UCI-Rocket-Project/rocket2-trs-hardware/README.md

## 🛰️ Telemetry Radio System (TRS) 🛰️
Click [here](https://uci-rocket-project.github.io/rocket2-trs-hardware/) TRS documentation
