UCI-Rocket-Project/rocket2-trs-hardware/docs/assets/av-system-diagram.png

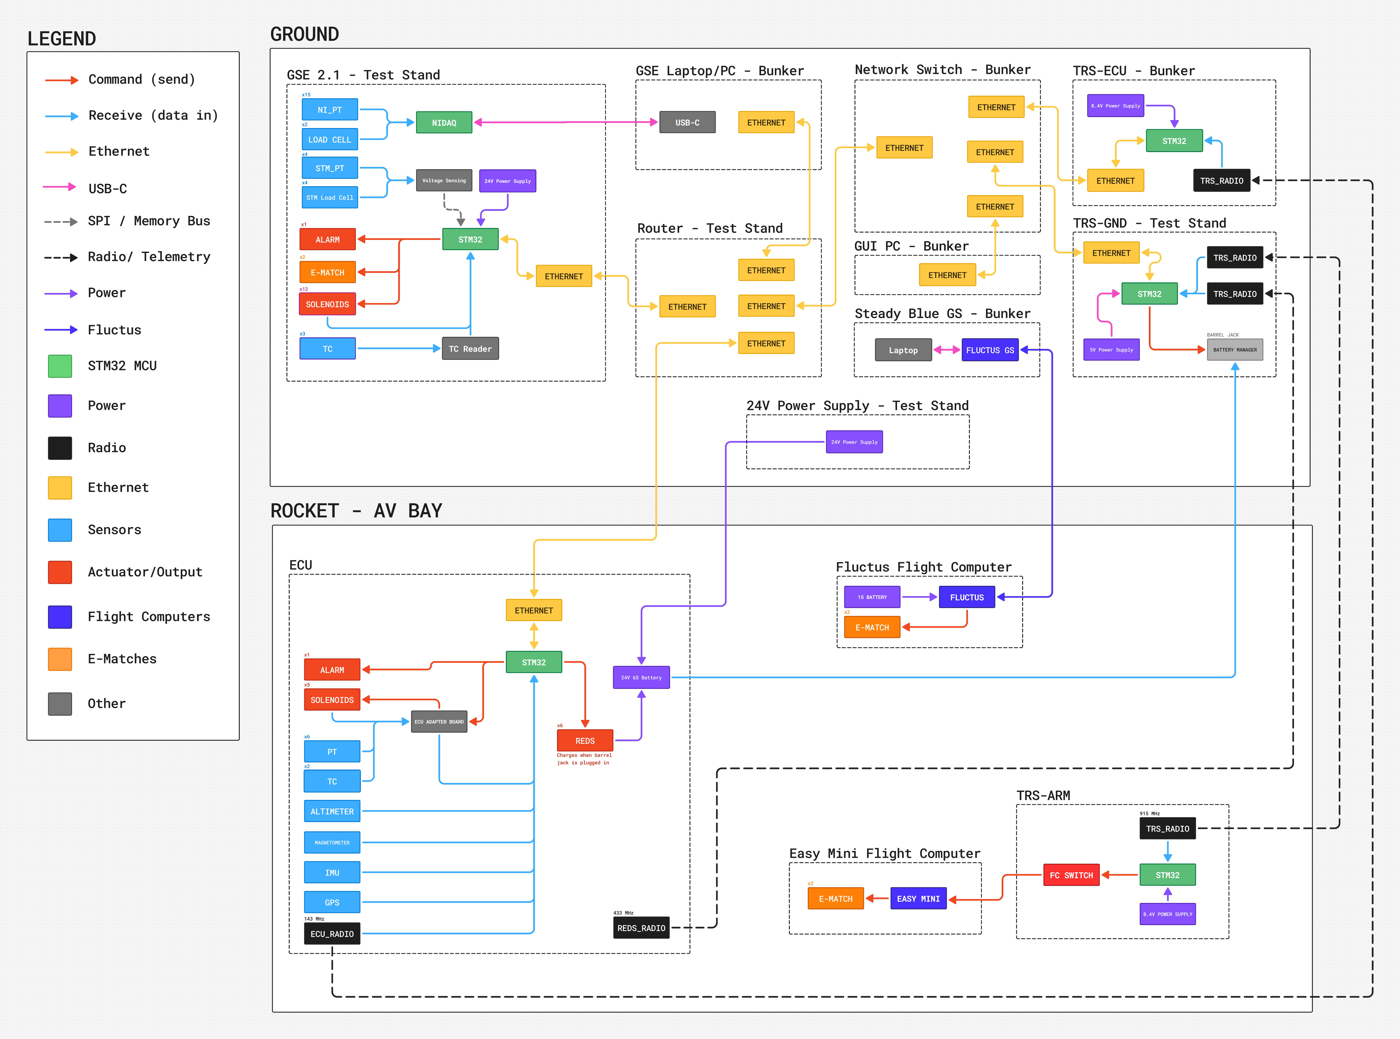
docs/assets/av-system-diagram.png
