UCI-Rocket-Project/rocket2-trs-hardware/TRS-KICAD/rocket2-trs-hardware.kicad_pcb

## KiCad design TRS-KICAD/rocket2-trs-hardware.kicad_pcb (2026-02-01)

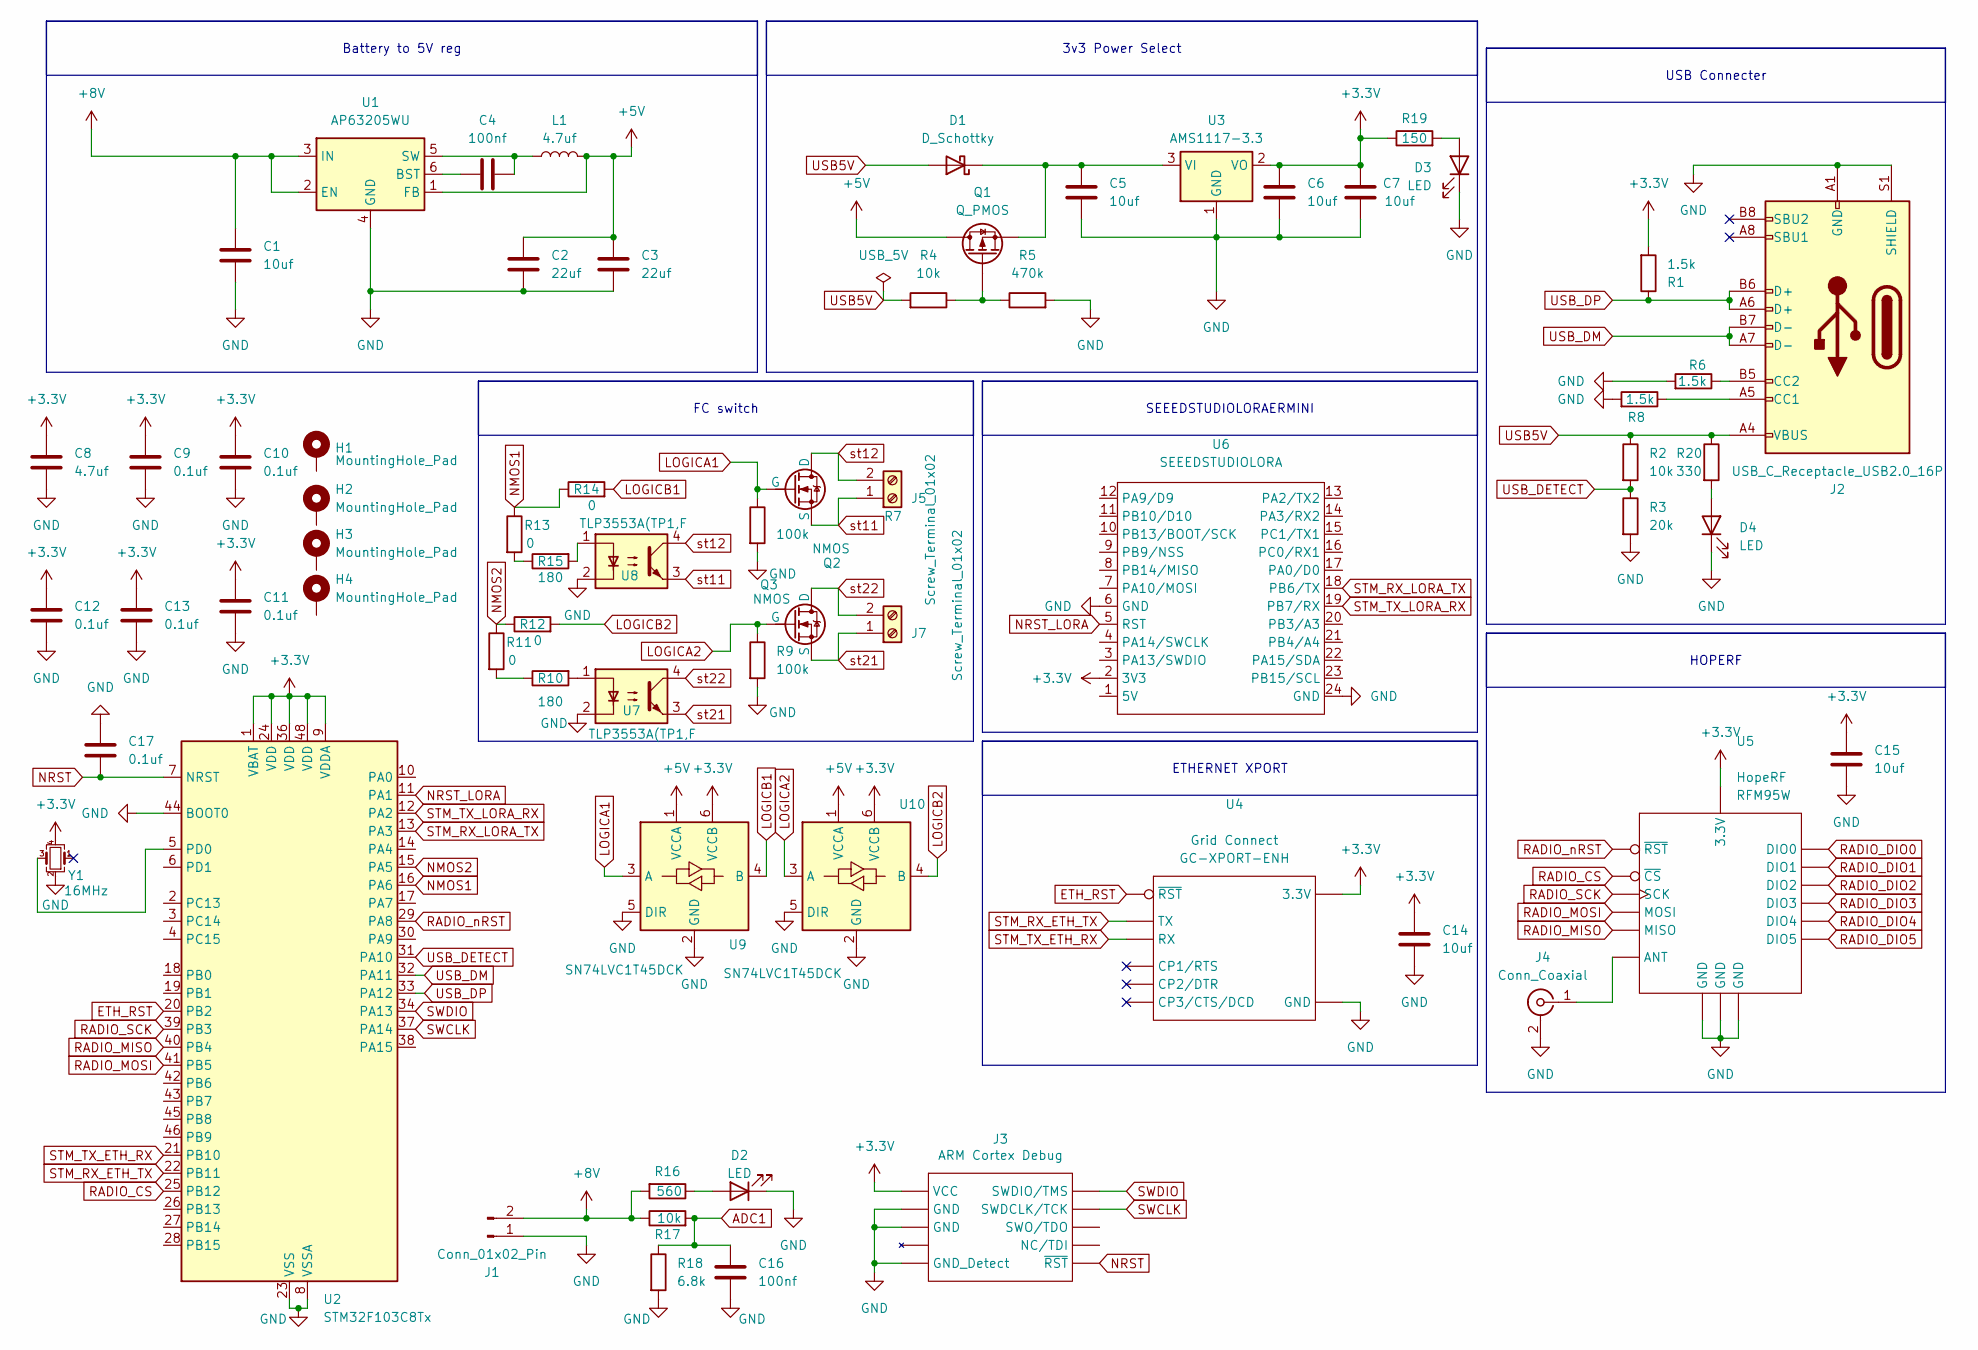
[picture p13: schematic rocket2-trs-hardware.kicad_sch]

Parts:
C1, C5, C6, C7, C14, C15: 10uf; C_0603_1608Metric_Pad1.08x0.95mm_HandSolder
C2, C3: 22uf; C_0603_1608Metric_Pad1.08x0.95mm_HandSolder
C4, C16: 100nf; C_0603_1608Metric_Pad1.08x0.95mm_HandSolder
C8: 4.7uf; C_0603_1608Metric_Pad1.08x0.95mm_HandSolder
C9, C10, C11, C12, C13, C17: 0.1uf; C_0603_1608Metric_Pad1.08x0.95mm_HandSolder
D1: D_Schottky; D_SMA_Handsoldering
D2, D3, D4: LED; R_0603_1608Metric_Pad0.98x0.95mm_HandSolder
H1, H2, H3, H4: MountingHole_Pad; MountingHole_4.3mm_M4_DIN965_Pad_TopBottom
J1: Conn_01x02_Pin; AMASS_XT60PW-M_1x02_P7.20mm_Horizontal
J2: USB_C_Receptacle_USB2.0_16P; USB_C_Receptacle_GCT_USB4105-xx-A_16P_TopMnt_Horizontal
J3: ARM Cortex Debug; PinHeader_2x05_P1.27mm_Vertical_SMD
J4: Conn_Coaxial; CONN_73391-0070_MOL
J5, J7: Screw_Terminal_01x02; TerminalBlock_Phoenix_MKDS-1,5-2-5.08_1x02_P5.08mm_Horizont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
L1: 4.7uf; C_0603_1608Metric_Pad1.08x0.95mm_HandSolder
Q1: Q_PMOS; TSOT-23_HandSoldering
Q2, Q3: NMOS; SOT-23-6
R1, R6, R8: 1.5k; R_0603_1608Metric_Pad0.98x0.95mm_HandSolder
R2, R4, R17: 10k; R_0603_1608Metric_Pad0.98x0.95mm_HandSolder
R3: 20k; R_0603_1608Metric_Pad0.98x0.95mm_HandSolder
R5: 470k; R_0603_1608Metric_Pad0.98x0.95mm_HandSolder
R7, R9: 100k; R_0603_1608Metric_Pad0.98x0.95mm_HandSolder
R10, R15: 180; R_0603_1608Metric_Pad0.98x0.95mm_HandSolder
R11, R12, R13, R14: 0; R_0603_1608Metric_Pad0.98x0.95mm_HandSolder
R16: 560; R_0603_1608Metric_Pad0.98x0.95mm_HandSolder
R18: 6.8k; R_0603_1608Metric_Pad0.98x0.95mm_HandSolder
R19: 150; R_0603_1608Metric_Pad0.98x0.95mm_HandSolder
R20: 330; R_0603_1608Metric_Pad0.98x0.95mm_HandSolder
U1: AP63205WU; TSOT-23-6
U2: STM32F103C8Tx; LQFP-48_7x7mm_P0.5mm
U3: AMS1117-3.3; SOT-223-3_TabPin2
U4: GC-XPORT; Part # GC-XPORT-ENH
U5: RFM95W; Part # RFM95W
U6: SEEEDSTUDIOLORA; Untitled
U7: TLP3553A(TP1,F; optocoupler
U8: TLP3553A(TP1,F; optocoupler; Part# TLP3553A(TP1,F
U9, U10: SN74LVC1T45DCK; SOT-363_SC-70-6
Y1: 16MHz; Crystal_SMD_2016-4Pin_2.0x1.6mm; Part # ECS-1633-160-BN-TR

Connections:
+3.3V: C6.1, C7.1, C8.1, C9.1, C10.1, C11.1, C12.1, C13.1, C14.1, C15.1, J3.1 (VCC), R1.2, R19.1, U2.1 (VBAT), U2.9 (VDDA), U2.24 (VDD), U2.36 (VDD), U2.48 (VDD), U3.2 (VO), U4.2 (3.3V), U5.13 (3.3V), U6.2 (3V3), U9.6 (VCCB), U10.6 (VCCB), Y1.4
+5V: C2.1, C3.1, L1.2, Q1.3 (D), U1.1 (FB), U9.1 (VCCA), U10.1 (VCCA)
+8V: C1.1, J1.2, R16.2, R17.1, U1.2 (EN), U1.3 (IN)
ADC1: C16.1, R17.2, R18.1
ETH_RST: U2.20 (PB2), U4.3 (~RST)
GND: C1.2, C2.2, C3.2, C5.2, C6.2, C7.2, C8.2, C9.2, C10.2, C11.2, C12.2, C13.2, C14.2, C15.2, C16.2, C17.2, D2.1 (K), D3.1 (K), D4.1 (K), J1.1, J2.A1 (GND), J2.A12 (GND), J2.B1 (GND), J2.B12 (GND), J2.S1 (SHIELD), J3.3 (GND), J3.5 (GND), J3.9 (GND_Detect), J4.2 (Ext), R3.2, R5.2, R6.2, R7.2, R8.2, R9.2, R18.2, U1.4 (GND), U2.8 (VSSA), U2.23 (VSS), U2.35 (VSS), U2.44 (BOOT0), U2.47 (VSS), U3.1 (GND), U4.1 (GND), U5.1 (GND), U5.8 (GND), U5.10 (GND), U6.6 (GND), U6.24 (GND), U7.2, U8.2, U9.2 (GND), U9.5 (DIR), U10.2 (GND), U10.5 (DIR), Y1.2
LOGICA1: Q2.3 (G), R7.1, U9.3 (A)
LOGICA2: Q3.3 (G), R9.1, U10.3 (A)
LOGICB1: R14.2, U9.4 (B)
LOGICB2: R12.2, U10.4 (B)
NMOS1: R13.1, R14.1, U2.16 (PA6)
NMOS2: R11.1, R12.1, U2.15 (PA5)
NRST: C17.1, J3.10 (~RST), U2.7 (NRST)
NRST_LORA: U2.11 (PA1), U6.5 (RST)
unnamed: C5.1, D1.1 (K), Q1.2 (S), U3.3 (VI)
unnamed: D2.2 (A), R16.1
unnamed: D3.2 (A), R19.2
unnamed: D4.2 (A), R20.2
unnamed: J2.A5 (CC1), R8.1
unnamed: J2.B5 (CC2), R6.1
unnamed: J4.1 (In), U5.9 (ANT)
unnamed: Q1.1 (G), R4.1, R5.1
unnamed: R10.1, R11.2
unnamed: R10.2, U7.1
unnamed: R13.2, R15.1
unnamed: R15.2, U8.1
unnamed: C4.2, U1.6 (BST)
unnamed: C4.1, L1.1, U1.5 (SW)
unnamed: U2.5 (PD0), Y1.3
RADIO_CS: U2.25 (PB12), U5.5 (~CS)
RADIO_DIO0: U5.14 (DIO0)
RADIO_DIO1: U5.15 (DIO1)
RADIO_DIO2: U5.16 (DIO2)
RADIO_DIO3: U5.11 (DIO3)
RADIO_DIO4: U5.12 (DIO4)
RADIO_DIO5: U5.7 (DIO5)
RADIO_MISO: U2.40 (PB4), U5.2 (MISO)
RADIO_MOSI: U2.41 (PB5), U5.3 (MOSI)
RADIO_SCK: U2.39 (PB3), U5.4 (SCK)
RADIO_nRST: U2.29 (PA8), U5.6 (~RST)
STM_RX_ETH_TX: U2.22 (PB11), U4.4 (TX)
STM_RX_LORA_TX: U2.13 (PA3), U6.18 (PB6/TX)
STM_TX_ETH_RX: U2.21 (PB10), U4.5 (RX)
STM_TX_LORA_RX: U2.12 (PA2), U6.19 (PB7/RX)
SWCLK: J3.4 (SWDCLK/TCK), U2.37 (PA14)
SWDIO: J3.2 (SWDIO/TMS), U2.34 (PA13)
USB5V: D1.2 (A), J2.A4 (VBUS), J2.A9 (VBUS), J2.B4 (VBUS), J2.B9 (VBUS), R2.1, R4.2, R20.1
USB_DETECT: R2.2, R3.1, U2.31 (PA10)
USB_DM: J2.A7 (D-), J2.B7 (D-), U2.32 (PA11)
USB_DP: J2.A6 (D+), J2.B6 (D+), R1.1, U2.33 (PA12)
st11: J5.1, Q2.4 (S), U8.3
st12: J5.2, Q2.1 (D), U8.4
st21: J7.1, Q3.4 (S), U7.3
st22: J7.2, Q3.1 (D), U7.4

Notes on the sheet:
FC switch
3v3 Power Select
HOPERF
USB Connecter
ETHERNET XPORT
SEEEDSTUDIOLORAERMINI
Battery to 5V reg

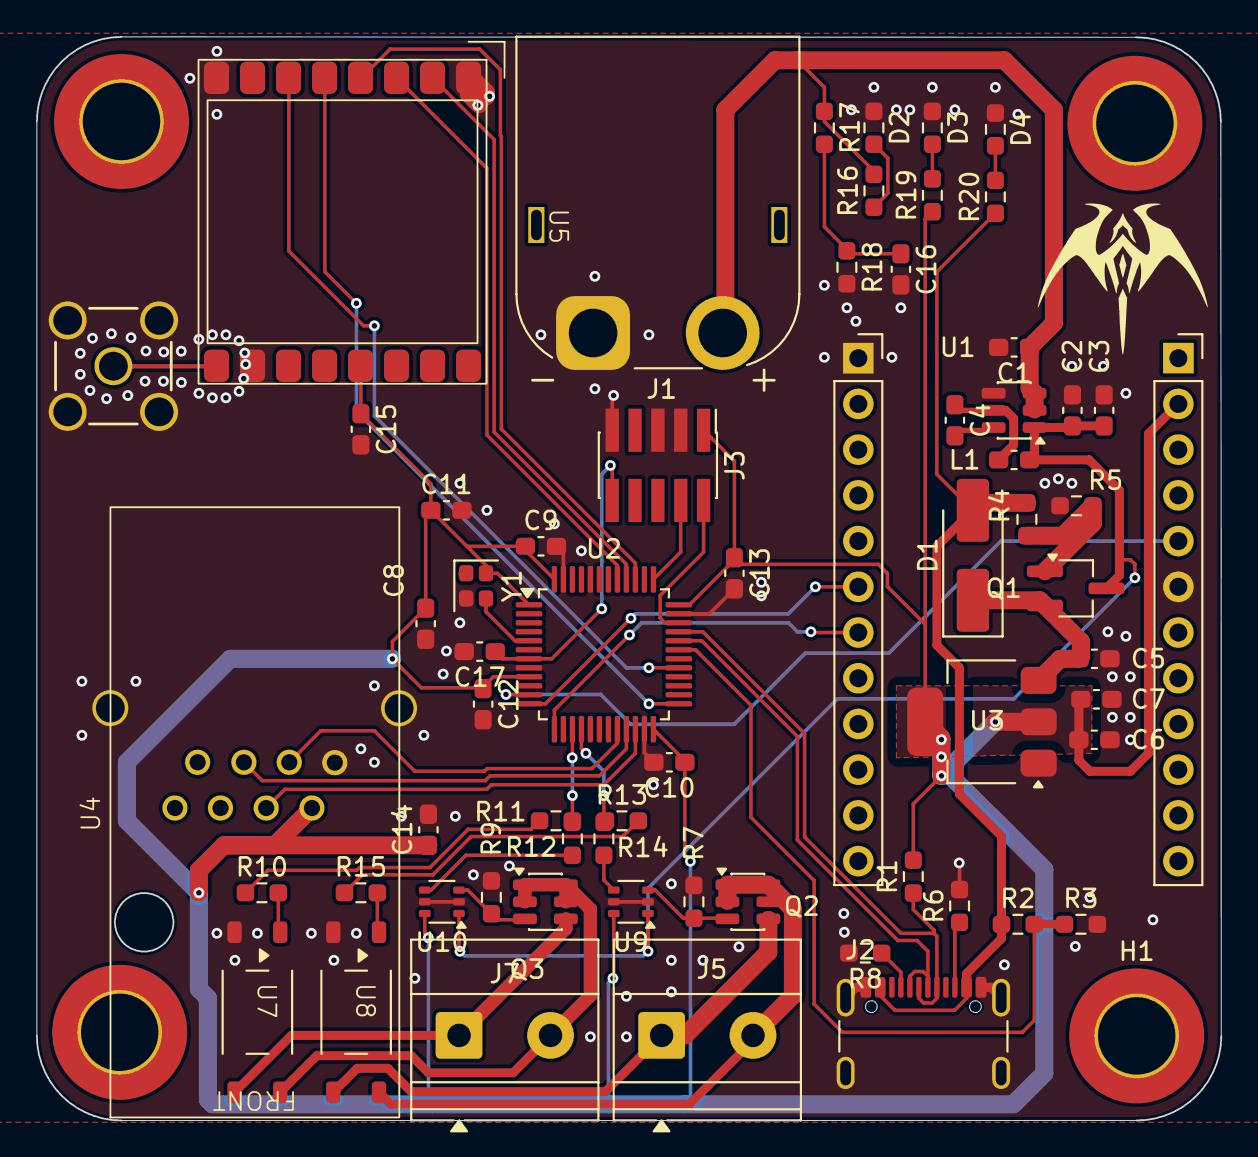
[picture p14: board rocket2-trs-hardware.kicad_pcb from above]

Board: 2 copper layers, 65.8 x 60.2 mm, 66 parts (0 on the bottom side), 48 nets.
