UCI-Rocket-Project/rocket2-trs-hardware/(commit log)

2024-01-25 Add schematic
    [rocket2-trs.kicad_sch]
2024-01-26 Add test points
    [rocket2-trs.kicad_sch]
2024-01-26 Add PCB
    [rocket2-trs.kicad_pcb, rocket2-trs.kicad_sch]
2024-01-26 Add LED
    [rocket2-trs.kicad_pcb, rocket2-trs.kicad_sch]
2025-11-15 TRS Update 1
    [rocket2-trs.kicad_pcb, rocket2-trs.kicad_sch]
2025-11-19 TRS 1
    [rocket2-trs.kicad_pcb]
2025-12-15 trs update 12/14/2025
    [rocket2-trs.kicad_pcb, rocket2-trs.kicad_sch]
2026-01-15 TRS fixed
    [rocket2-trs.kicad_pcb, rocket2-trs.kicad_sch]
2026-01-16 added test points, removed connectors
    [rocket2-trs.kicad_pcb, rocket2-trs.kicad_sch]
2026-01-21 adding nmos
    [rocket2-trs.kicad_sch]
2026-01-22 added nmos and fixed rx tx
    [rocket2-trs.kicad_pcb, rocket2-trs.kicad_sch]
2026-01-23 Fixed board size and removed eth from lora
    [rocket2-trs.kicad_pcb, rocket2-trs.kicad_sch]
2026-01-26 layout revised
    [Untitled.kicad_pcb]
2026-01-26 signal routing start
    [Untitled.kicad_pcb, Untitled.kicad_sch]
2026-01-27 optocouplers added
    [Untitled.kicad_pcb, Untitled.kicad_sch]
2026-01-29 cleaned up layout and board shape finalized
    [Untitled.kicad_pcb, Untitled.kicad_sch]
2026-01-31 prereview board
    [Untitled.kicad_pcb, Untitled.kicad_sch]
2026-02-01 TRS production ready
    [Untitled.kicad_pcb, rocket2-trs-hardware.kicad_pcb, rocket2-trs-hardware.kicad_sch, rocket2-trs.kicad_pcb, rocket2-trs.kicad_sch]
2026-04-29 Reformatted repo file structure
    [rocket2-trs-hardware.kicad_pcb, rocket2-trs-hardware.kicad_sch]
2026-05-06 Added sys diagram, circuit photos, tightened descriptions, added master hardware page and added trs-gnd hardware page
